thestealth131205/BMW-OBD2-Display/assets/multi_bg.jpg

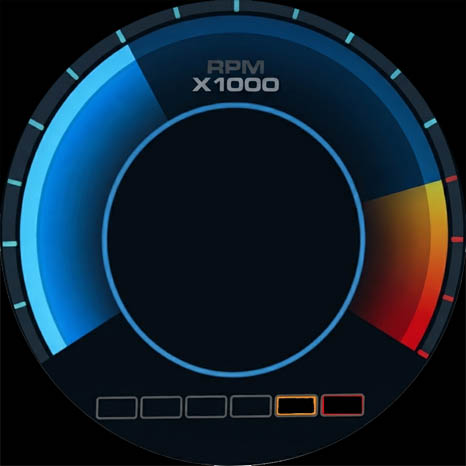
assets/multi_bg.jpg
