thestealth131205/BMW-OBD2-Display/2.1 LCD/demo projekt/esp-idf - ESP32-S3-Touch-LCD-2.1-Test/README.md

# BMW E90 OBD2 Display – ESP32-S3-Touch-LCD-2.1 (RGB, ESP-IDF)

Portierung der BMW-E90-Multi-Anzeige (siehe Haupt-`CLAUDE.md` im Repo-Root) auf
das Waveshare-Board **ESP32-S3-Touch-LCD-2.1** (480×480 ST7701S RGB-Display,
CST820-Touch). Framework: **ESP-IDF** (nicht Arduino/PlatformIO), LVGL v8.2
via ESP Component Manager. Basis ist das offizielle Waveshare-Demo-Projekt,
darauf aufgebaut liegt die BMW-UI in `main/BMW_UI/`.

Der eingebaute Waveshare-Demo-Screen bleibt erreichbar: **3 Sekunden Touch in
der Bildschirmmitte** zeigt ihn an, ein „Zurück“-Button führt zur BMW-Ansicht
zurück. **Doppeltipp** in der Mitte öffnet den Farb-Einstellungsbildschirm.

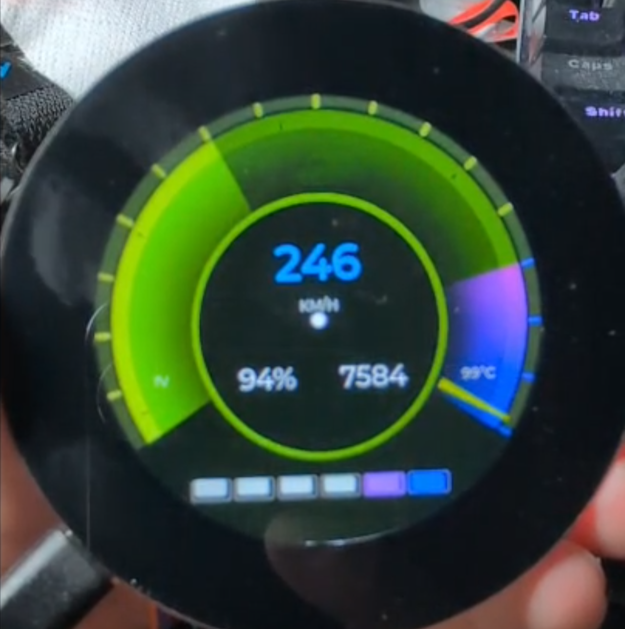
[picture p4: 2.1 LCD/demo projekt/esp-idf - ESP32-S3-Touch-LCD-2.1-Test/docs/multi_view_photo.png]
Multi-Ansicht auf dem Display


## Hardware

| Komponente | Modell |
|---|---|
| Mikrocontroller | ESP32-S3 (Waveshare ESP32-S3-Touch-LCD-2.1) |
| Display | ST7701S RGB-TFT, 480×480, über SPI-Init + paralleles RGB-Interface |
| Touch | CST820 (kapazitiv), I2C |
| IO-Expander | TCA9554 (Adresse 0x20) – steuert u. a. Touch-Reset/weitere Enable-Leitungen |
| CAN-Bus | externes **MCP2515-Modul** (SPI, TJA1050-Transceiver) oder alternativ **BLE-OBD-Adapter** (Veepeak OBDCheck BLE) |
| Batteriemessung | interner ADC (Spannungsteiler auf dem Board) |

Board-eigene Peripherie (RTC PCF85063, IMU QMI8658, microSD, WLAN) ist aus dem
Waveshare-Demo übernommen und unverändert nutzbar, wird von der BMW-UI aber
nicht benötigt.

## Verdrahtungsplan

### ST7701S-Display (fest verlötet, keine externe Verdrahtung nötig)

Das Display ist bereits fest mit dem ESP32-S3-Modul verlötet (Waveshare-
Compound-Board). Pin-Zuordnung nur zur Referenz (`main/LCD_Driver/ST7701S.h`):

| Signal | GPIO | Signal | GPIO |
|---|---|---|---|
| SPI SDA (Init) | 1 | SPI SCLK (Init) | 2 |
| HSYNC | 38 | VSYNC | 39 |
| DE | 40 | PCLK | 41 |
| Backlight (PWM) | 6 | | |
| B0–B4 (DATA0–4) | 5, 45, 48, 47, 21 | | |
| G0–G5 (DATA5–10) | 14, 13, 12, 11, 10, 9 | | |
| R0–R4 (DATA11–15) | 46, 3, 8, 18, 17 | | |

### I2C-Bus (Touch CST820 + IO-Expander TCA9554)

| Signal | GPIO |
|---|---|
| SCL | 7 |
| SDA | 15 |
| Touch-INT | 16 |
| Touch-RST | -1 (nicht verbunden, Reset über TCA9554) |

Ebenfalls fest verlötet, keine externe Verdrahtung nötig.

### MCP2515-CAN-Modul (extern anzuschließen – einzige Verdrahtung, die der
Nutzer selbst vornehmen muss)

**Wichtig:** Auf dem ESP32-S3-Touch-LCD-2.1 sind fast alle GPIOs durch das
RGB-Display und I2C belegt. Nur **GPIO 0, 19, 20, 43, 44** sind frei
herausgeführt. Verdrahtung des MCP2515-Moduls (blaue Platine mit TJA1050,
`main/CAN_Driver/mcp2515.h`):

| MCP2515-Modul | ESP32-S3 GPIO | Funktion |
|---|---|---|
| VCC | 3V3 | Versorgung |
| GND | GND | Masse |
| SCK | GPIO43 | SPI-Takt |
| SI (MOSI) | GPIO44 | SPI Data ESP→MCP2515 |
| SO (MISO) | GPIO19 | SPI Data MCP2515→ESP |
| CS | GPIO20 | SPI Chip-Select |
| INT | *nicht verbunden* | reiner Software-Poll über SPI (`mcp2515.c`), kein ISR-Pin nötig |

**GPIO0 bleibt dadurch dauerhaft frei** für den LED-Control-Screen (siehe
unten) – unabhängig davon, ob BLE-OBD oder MCP2515 als Datenquelle gewählt
ist.

Danach MCP2515 → CAN-Transceiver (TJA1050 ist meist schon auf dem Modul
integriert) → BMW E90 OBD2-Stecker:

| OBD2-Pin | Signal |
|---|---|
| Pin 6 | CANH |
| Pin 14 | CANL |

Baudrate: **500 kbit/s**. Quarz auf dem MCP2515-Modul muss zu
`MCP2515_XTAL_MHZ` in `mcp2515.h` passen (Standard: 8 MHz – am Modul
nachprüfen, sonst stimmt die Baudrate nicht).

**Achtung Pin-Konflikt:** GPIO43/44 sind gleichzeitig die UART-Konsole des
ESP32-S3. Mit dieser Pinbelegung ist die serielle Debug-Ausgabe (`idf.py
monitor`) zur Laufzeit nicht nutzbar (Flashen funktioniert weiterhin über den
USB-Download-Modus). GPIO19/20 sind außerdem die nativen-USB-Pins – auch diese
Funktion steht dadurch nicht mehr zur Verfügung.

## Software / Build

```bash
# Im Projektverzeichnis (ESP-IDF-Environment muss aktiviert sein, z. B. via
# `. $HOME/esp/esp-idf/export.sh`)
idf.py set-target esp32s3
idf.py build
idf.py -p PORT flash monitor
```

- **LVGL** wird per Component-Manager (`main/idf_component.yml`) geladen,
  Version 8.2. Der vendorte Ordner `components/lvgl__lvgl/` wird von CI/Build
  automatisch nachgezogen und ist per `.gitignore` vom Repo ausgeschlossen.
- **Flash-Layout**: 16 MB, Zwei-Slot-OTA-Partitionstabelle (`ota_0`/`ota_1` à
  3 MB + `otadata`, siehe `partitions.csv`) – ein WLAN-Update schreibt immer
  in den gerade nicht laufenden Slot, ein fehlgeschlagener Upload überschreibt
  also nie die aktuell laufende Firmware.
- **CI**: `.github/workflows/build-s3.yml` baut das Projekt per
  `espressif/esp-idf-ci-action` (ESP-IDF v5.3.1, Target `esp32s3`) und lädt
  bei Push auf `test_waveshare` drei Dateien in das GitHub-Release
  **`s3-latest`** sowie zusätzlich versioniert in **`v<Version>`**
  (Version aus `VERSION`):
  - **`firmware-s3-update.bin`** – reines App-Image, für das **WLAN-Update**
    (siehe unten). Name bewusst mit `_update`-Suffix, damit er sich nicht mit
    der `-merged.bin` verwechseln lässt.
  - **`firmware-s3.elf`** – fürs Debugging (Backtrace-Symbole).
  - **`firmware-s3-merged.bin`** – Bootloader + Partitionstabelle + App,
    gemerged an den Offsets `0x0`/`0x8000`/`0x20000`, nur fürs **initiale
    USB-Flashen** gedacht (`esptool write-flash 0x0 firmware-s3-merged.bin`).

## WLAN-Firmware-Update (OTA)

Im originalen Waveshare-Onboard-Panel (3 Sekunden Touch in der
Bildschirmmitte → dort wo auch Helligkeit/SD-Größe/RTC stehen) gibt es einen
Schalter **„WLAN-Update“**. Aktiviert er:

1. Das Display baut einen eigenen WLAN-Access-Point auf
   (SSID `BMW-E90-OTA`, Passwort `bmw320i2010`) und zeigt SSID/Passwort/IP
   sowie einen Fortschrittsbalken an.
2. Handy/PC verbindet sich mit diesem WLAN und ruft `http://192.168.4.1` im
   Browser auf.
3. Dort **nur die Datei `firmware-s3-update.bin`** auswählen und hochladen –
   **nicht** die `-merged.bin`, die ist ausschließlich fürs USB-Flashen.
4. Nach erfolgreichem Upload schreibt das Display `esp_ota_set_boot_partition`
   und startet automatisch in die neue Firmware neu.

**Schutz vor der falschen Datei:** `main/OTA_Web/ota_web.c` liest nach den
ersten paar hundert empfangenen Bytes den App-Beschreibungsblock
(`esp_app_desc_t`) aus der gerade beschriebenen Partition zurück
(`esp_ota_get_partition_description`). Fehlt dort das erwartete
`ESP_APP_DESC_MAGIC_WORD` – z. B. weil versehentlich die `-merged.bin`
hochgeladen wurde, bei der an dieser Stelle der Bootloader statt des
App-Headers steht – bricht der Upload sofort mit einer Fehlermeldung ab,
statt eine ungültige Firmware zu flashen.

**Wichtig:** Da `partitions.csv` ein Zwei-Slot-OTA-Layout ist, muss nach
einer Änderung der Partitionstabelle selbst einmal regulär per USB geflasht
werden – danach funktioniert das WLAN-Update für alle folgenden Versionen.

## RTC-Zeitabgleich per SNTP über Hotspot

Eigenes Modul `main/SNTP/sntp_sync.c`, unabhängig vom WLAN-Update-AP oben:
Hier verbindet sich das Display als **Client** mit einem WLAN, das
Internetzugang hat (Handy-Hotspot/Heim-WLAN), um die PCF85063-RTC einmalig
per SNTP (`pool.ntp.org`) zu stellen.

- Ausgelöst wird das **ausschließlich** über den Schalter **„Hotspot
  verbinden“** im Funktionen-Screen (Doppeltipp → Wisch rechts, siehe
  BMW-UI-Logik unten) – **kein** automatischer Versuch beim Boot, damit die
  BLE-OBD-Verbindung nicht unbeabsichtigt (z. B. während der Fahrt) gestört
  wird.
- Zugangsdaten stehen in `/sdcard/wifi-einstellungen.txt` auf der SD-Karte
  (bewusst nicht im Code, dieses Repo ist öffentlich). Fehlt die Datei noch,
  legt der erste Versuch automatisch eine Vorlage mit Beispiel an.
- Ablauf: BLE-OBD kurz pausieren (gleiche Antennen-Koexistenz wie beim
  WLAN-Update) → per STA verbinden → SNTP-Sync → Zeit lokal (inkl.
  Sommerzeit) in die RTC schreiben → BLE-OBD fortsetzen. Ein Statustext unter
  dem Schalter zeigt den Fortschritt, der Schalter fällt nach dem (einmaligen)
  Versuch automatisch wieder ab.
- Der Schalterzustand wird **nicht** in NVS gespeichert – nach jedem Neustart
  ist er wieder aus. Mit einer RTC-Pufferbatterie reicht ein einziger
  erfolgreicher Abgleich.

**SD-Karte formatieren** (`SD_MMC.c: SD_Format()`): Button direkt unter dem
Hotspot-Schalter im Funktionen-Screen, für unformatierte/beschädigte Karten
(z. B. „SD-Fehler!“ bei Datenlogging oder „Fehler: zu wenig Speicher“ beim
Hotspot-Task, weil `SD_EnsureMounted()` nie erfolgreich mountet). Ist die
Karte bereits gemountet, läuft `esp_vfs_fat_sdcard_format()` (hängt selbst
aus/ein); ist sie es nicht, erfolgt ein einmaliger erzwungener
Formatierungs-Mount (`format_if_mount_failed=true`). Aktives Datenlogging
wird vorher gestoppt, die eigentliche Formatierung läuft in einem eigenen
Task, damit die UI währenddessen nicht einfriert.

## OBD2 / CAN-Auswertung (MCP2515-Quelle)

Läuft über `main/CAN_Driver/` (eigener MCP2515-SPI-Treiber +
Decode-Task, kein ESP-IDF-`twai`). CAN-IDs identisch zum C6-Hauptprojekt –
**Platzhalter**, am Fahrzeug per CAN-Sniffer verifizieren:

| CAN-ID | Inhalt |
|---|---|
| `0x0AA` | Drehzahl (Byte 2–3 LE × 0,25 = U/min) |
| `0x0C4` | G-Kraft (Byte 0/1 int8 × 0,01 = g) + Geschwindigkeit (Byte 2–3 LE × 0,1 = km/h) |
| `0x1D0` | Kühlmitteltemperatur (Byte 0 − 40 = °C) |
| `0x1F0` | Gaspedalstellung (Byte 0 linear 0–255 → 0–100 %) |
| `0x7DF` | OBD2-Funktionsadresse (DTC lesen/löschen, Mode 03/04) |
| `0x611` | Kombiinstrument (CBS-Öl-Service-Reset, UDS Service `0x31`) |

Solange kein CAN-Signal anliegt (`CAN_OBD2_online()` == false), zeigt die UI
Platzhalterwerte/Testanimation an. Batteriespannung kommt weiterhin vom
internen ADC (`BAT_Driver`), nicht von CAN.

## Datenquelle: BLE-OBD oder MCP2515

Das Display kann seine Live-Daten aus zwei Quellen beziehen. Die Auswahl
erfolgt im Demo-Menü (**3 Sekunden Touch in der Bildschirmmitte**) über die
Buttons **„BLE OBD“** und **„MCP“** (aktive Quelle grün). **Standard ist
BLE OBD.** Die Wahl gilt für alle Live-Werte, DTC-Lesen/-Löschen,
Service-Reset und das CSV-Logging.

| Quelle | Hardware | Modul |
|---|---|---|
| **BLE OBD** (Standard) | ELM327-Adapter mit Bluetooth LE, z. B. **Veepeak OBDCheck BLE** | `main/BLE_OBD/` |
| **MCP** | MCP2515-Modul direkt am PT-CAN (siehe Verdrahtung oben) | `main/CAN_Driver/` |

### BLE-OBD-Adapter (Veepeak OBDCheck BLE)

- Der ESP32-S3 hat nur **Bluetooth 5 LE**, kein klassisches Bluetooth
  (BR/EDR/SPP). Adapter, die nur klassisches Bluetooth sprechen (z. B.
  Veepeak **VP11**), können deshalb **nicht** verbunden werden – es muss ein
  BLE-Adapter sein.
- Beim Start initialisiert das Display Bluetooth und scannt fortlaufend nach
  Geräten, deren Name `OBD`, `VEEPEAK`, `VLINK` oder `ELM327` enthält
  (Groß-/Kleinschreibung egal). Der Veepeak-Adapter meldet sich als
  **VEEPEAK**. Bei Fund wird automatisch verbunden.
- Die GATT-Charakteristiken (Notify = RX, Write = TX) werden generisch
  erkannt, da ELM327-Klone unterschiedliche UUIDs verwenden.
- **Kopplung:** Bei BLE ist normalerweise keine Kopplung nötig (Sicherheit:
  `ESP_LE_AUTH_NO_BOND`). Verlangt ein Adapter dennoch eine PIN, probiert das
  Display nacheinander **1234 → 5678 → 0000**.
- Nach dem Verbinden: `ATZ`, `ATE0`, `ATH0`, `ATSP6` (ISO 15765-4 CAN,
  500 kbit/s), danach zyklisches Polling per Standard-OBD2:
  Drehzahl, Geschwindigkeit, Kühlmitteltemperatur, Gaspedalstellung,
  Batteriespannung (`ATRV`) sowie DTC lesen/löschen (Mode 03/04) und
  Service-Reset.
- **Einschränkung:** G-Kraft ist über Standard-OBD2 nicht verfügbar und
  bleibt bei BLE-OBD auf 0,0 – dafür wird die MCP-Quelle benötigt.
- Der BLE-Scan startet erst ca. 7 s nach dem Boot, um den bestehenden Scan
  der Waveshare-Demo (`Wireless.c`) nicht zu stören.
- Ein BLE-Adapter benötigt **keine** Verdrahtung – GPIO19/20/43/44 bleiben bei
  reiner BLE-Nutzung frei (MCP2515 dann nicht anschließen).

## LED-Steuerung (WS2812B/SK6812)

Wisch nach oben auf der Multi-Ansicht öffnet den Screen „LED CONTROL“
(`main/LED_Control/led_ctrl.c`, RMT-Backend über die Komponente
`espressif/led_strip`), Wisch nach unten geht zurück. **Zwei unabhängig
steuerbare Streifen**, oben im Screen per Tab umschaltbar, beide laufen im
Hintergrund parallel weiter.

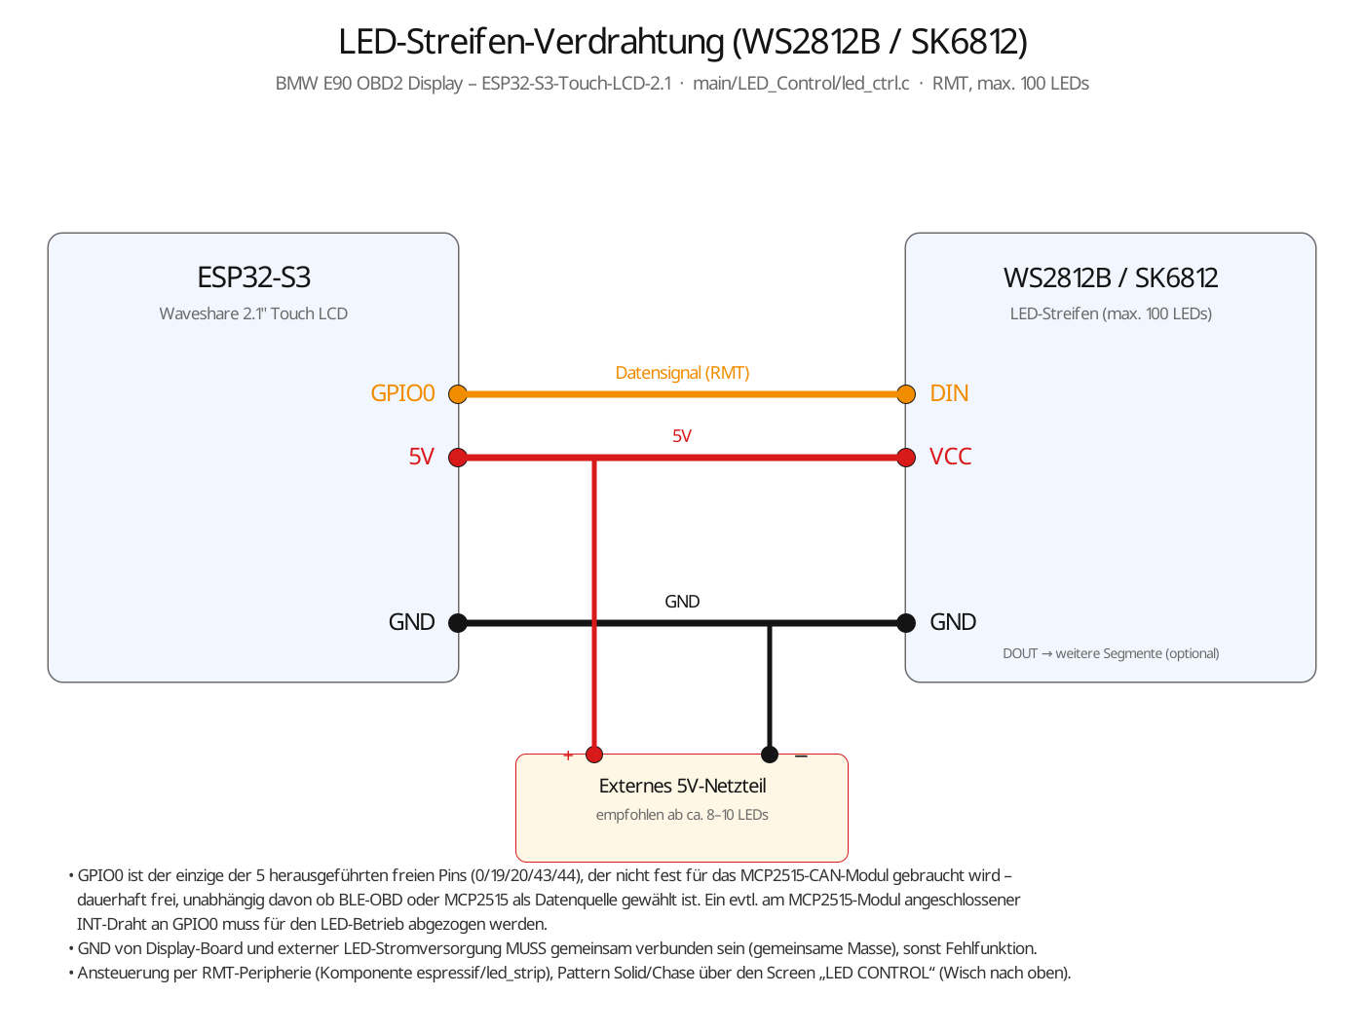
[picture p5: 2.1 LCD/demo projekt/esp-idf - ESP32-S3-Touch-LCD-2.1-Test/docs/led_wiring.png]
LED-Streifen-Verdrahtung


| Streifen | ESP32-S3 GPIO | Funktion |
|---|---|---|
| Streifen 1 – DIN | **GPIO0** | WS2812/SK6812-Protokoll (RMT), immer frei |
| Streifen 2 – DIN | **GPIO19** | WS2812/SK6812-Protokoll (RMT), **= MCP2515-MISO** |
| VCC (beide) | 5V (extern, je nach LED-Anzahl – ab ca. 8–10 LEDs direkt vom KFZ-Bordnetz per 12V→5V-Step-Down statt vom ESP32-Board) | Versorgung |
| GND (beide) | GND | Masse |

- GPIO0 (Streifen 1) ist dauerhaft frei, unabhängig von der BLE/MCP-
  Datenquellenwahl. Ein evtl. am MCP2515-Modul angeschlossener INT-Draht an
  GPIO0 muss für den Streifen-1-Betrieb abgezogen werden.
- GPIO19 (Streifen 2) ist identisch mit MCP2515-MISO – SPI braucht alle 4
  Leitungen, Streifen 2 und das (verkabelte) MCP2515-Modul schließen sich
  deshalb gegenseitig aus. Für Streifen 2 muss die Datenquelle auf BLE-OBD
  stehen; die UI zeigt auf dem Streifen-2-Tab einen Warnhinweis, solange die
  Datenquelle trotzdem auf MCP2515 steht.
- Je Streifen: max. 100 LEDs, Ein-/Ausschalter (RMT-Ausgang wird erst bei
  aktivem Schalter konfiguriert), zwei Muster: **Solid** (eine Farbe) und
  **Chase** (Hauptfarbe als Hintergrund, Zweitfarbe läuft mit kurzem Schweif
  im Loop, Geschwindigkeit per Regler).
- Anzahl und beide Farben (10er-Palette, volle 8-Bit-RGB-Werte statt der
  RGB565-Display-Darstellung) je Streifen separat per Regler/Farbauswahl
  einstellbar, alle Einstellungen beider Streifen in NVS gespeichert.

## UI-Logik (Kurzfassung)

- **Boot-Logo**: Direkt nach der LVGL-Initialisierung zeigt das Display
  1,8 Sekunden lang ein Vollbild-Logo auf schwarzem Grund
  (`main/BMW_UI/boot_logo_img.c/.h`, 480×480 RGB565), bevor die eigentliche
  UI (Demo-Screen + BMW-Multi-Ansicht) aufgebaut wird.

Details zur BMW-Multi-Ansicht (Anzeigen, Farbzonen, Schwellenwerte, Nadeln,
Einstellungs-Screen) siehe Haupt-`CLAUDE.md` im Repo-Root – die Logik ist
weitgehend 1:1 vom C6-Projekt übernommen (`main/BMW_UI/bmw_ui.c`). Abweichungen
zum C6-Projekt:

- Ringnadel der Multi-Kachel zeigt Kühlmitteltemperatur (Skala 40–119 °C,
  ab 95 °C Farbwechsel), Drehzahl bleibt zusätzlich digital sichtbar.
- Zusätzliche, immer aktive innere Leuchtskala (Vorbild: segmentierte
  Kühlmitteltemperatur-Anzeige im BMW-Kombiinstrument): zeigt unabhängig vom
  gewählten Anzeige-Modus des Haupt-Rings (Wasser/Drehzahl) stets die
  Kühlmitteltemperatur – Blau als Grundfarbe, ab 100 °C Orange, ab 115 °C Rot.
- Schaltpunkt-Kästchen (6 Stück) füllen sich einzeln je nach Drehzahl
  (aktuelle Schwellen: 1500/2500/3500/4500/5500/6500 U/min), ab 6800 U/min
  blinken alle gemeinsam.
- Farbverwaltung/Nadel-Auswahl per Einstellungs-Screen (Doppeltipp), analog
  zur Farbpalette im C6-Projekt.
- Funktionen-Screen (Wisch rechts ab Einstellungs-Screen) enthält zusätzlich
  den Schalter „Hotspot verbinden“ für den manuellen RTC-Zeitabgleich per
  SNTP (siehe eigener Abschnitt oben) – im C6-Projekt nicht vorhanden.
- Neuer Screen „SENSOREN“ (Wisch rechts ab dem Service-Screen, Wisch links
  zurück): reine Digitalwert-Anzeige, 4 Zeilen × 2 Spalten – Lambda Sensor
  1/2 oben, darunter deren Spannungswerte, darunter Ansaugkrümmerdruck (MAP)
  und Ladedruck, unten Nockenwellen-Position Einlass/Auslass. Lambda
  (`BLE_OBD_lambda1_ratio()`/`..._voltage()` bzw. `CAN_OBD2_...`, PID 0x24/
  0x25) und Ansaugdruck (PID 0x0B) kommen live von der eingestellten
  Datenquelle. Ladedruck und Nockenwellen-Position liefern immer -1.0
  (Anzeige „n/v“): Für Ladedruck gibt es keine standardisierte Mode-01-PID
  und der N43B20A hat laut Haupt-`CLAUDE.md` ohnehin keinen Turbo; für die
  VANOS-Nockenwellenposition existiert gar kein Standard-OBD2-PID, das wäre
  nur per BMW-spezifischem UDS-Identifier auslesbar und wurde bewusst nicht
  blind nachgebaut (ungeprüfte Diagnosebefehle an Steuergeräte sind riskant,
  vgl. die ebenfalls offenen Punkte NOx-Regeneration/Bremsenentlüften im
  Service-Screen). Die Zuordnung „Lambda 1/2“ zu „Bank 1/2“ ist eine Annahme
  – Standard-OBD2 nummeriert O2-Sensoren 1–8 durchlaufend, die Zuordnung zu
  Bank1/Bank2 ist fahrzeugabhängig; beim N43 als Reihenmotor mit nur einer
  Bank sind das vermutlich Sensor vor/nach Kat derselben Bank, nicht zwei
  getrennte Bänke – am Fahrzeug noch zu verifizieren.
- Neuer Screen „LED CONTROL“ (Wisch oben ab der Multi-Ansicht, Wisch unten
  zurück): Ansteuerung eines WS2812B/SK6812-Streifens an GPIO0 (siehe eigener
  Abschnitt oben) – im C6-Projekt nicht vorhanden.
