thestealth131205/BMW-OBD2-Display/2.1 LCD/demo projekt/esp-idf - ESP32-S3-Touch-LCD-2.1-Test/main/main.c

#include <stdio.h>
#include <inttypes.h>
#include "sdkconfig.h"
#include "freertos/FreeRTOS.h"
#include "freertos/task.h"
#include "freertos/semphr.h"
#include "TCA9554PWR.h"
#include "PCF85063.h"
#include "QMI8658.h"
#include "ST7701S.h"
#include "CST820.h"
#include "SD_MMC.h"
#include "sd_log.h"
#include "sd_update.h"
#include "LVGL_Driver.h"
#include "LVGL_Example.h"
#include "Wireless.h"
#include "bmw_ui.h"
#include "can_obd2.h"
#include "ble_obd.h"
#include "sntp_sync.h"
#include "led_ctrl.h"
#include "esp_core_dump.h"
#include "boot_logo_img.h"

// Boot-Start-Logo: kurz auf schwarzem Grund anzeigen, bevor die eigentliche
// UI (Demo-Screen + BMW-Multi-Ansicht) aufgebaut wird. LVGL braucht dafuer
// bereits einen laufenden Tick-Timer (siehe LVGL_Init()); der eigentliche
// Refresh passiert erst durch die manuellen lv_timer_handler()-Aufrufe in
// dieser Funktion, da die Haupt-while(1)-Schleife erst danach startet.
#define BOOT_LOGO_HOLD_MS 1800

static lv_obj_t *show_boot_logo(void)
{
    lv_obj_t *scr_boot = lv_obj_create(NULL);
    lv_obj_set_style_bg_color(scr_boot, lv_color_black(), 0);
    lv_obj_set_style_bg_opa(scr_boot, LV_OPA_COVER, 0);
    lv_obj_set_style_border_width(scr_boot, 0, 0);

    lv_obj_t *logo = lv_img_create(scr_boot);
    lv_img_set_src(logo, &boot_logo_img);
    lv_obj_center(logo);

    lv_scr_load(scr_boot);

    uint32_t waited = 0;
    while (waited < BOOT_LOGO_HOLD_MS) {
        lv_timer_handler();
        vTaskDelay(pdMS_TO_TICKS(10));
        waited += 10;
    }

    return scr_boot;
}

// Die Boot-Loops/Abstuerze waehrend der Fahrt liessen sich bisher nicht
// diagnostizieren, weil der echte Panic-Grund/Backtrace nur auf der seriellen
// USB-Konsole ausgegeben wird - im Auto ist kein Rechner angeschlossen. Mit
// CONFIG_ESP_COREDUMP_ENABLE_TO_FLASH landet ein Crash-Dump stattdessen auf
// der eigenen "coredump"-Partition (partitions.csv) und bleibt bis zum
// naechsten Boot erhalten. Hier wird er beim Start geprueft, die wichtigsten
// Angaben (Absturzursache, Programmzaehler, Backtrace-Adressen) gehen ins
// SD-Log, danach wird der Dump geloescht, damit er nicht erneut gemeldet wird.
static void log_and_clear_coredump(void)
{
    if (esp_core_dump_image_check() != ESP_OK) {
        return; // kein Dump vorhanden
    }

    // Erst loeschen, dann (bestenfalls) auswerten: Ein beschaedigter Dump
    // (z. B. durch einen Reset waehrend des Schreibens) kann das Parsen in
    // esp_core_dump_get_summary() selbst zum Absturz bringen - das wuerde
    // einen Boot-Loop erzeugen, der sich nie aufloest, weil der fehlerhafte
    // Dump sonst bis zum naechsten Boot liegen bleibt und wieder geparst
    // wird. Mit dem Loeschen zuerst ist der Loop spaetestens nach einem
    // einzigen Absturz durchbrochen, auch wenn die Diagnose-Zeile darunter
    // selbst nicht mehr zustande kommt.
    esp_core_dump_summary_t summary;
    esp_err_t summary_err = esp_core_dump_get_summary(&summary);

    esp_core_dump_image_erase();

    if (summary_err == ESP_OK) {
        SD_Log("=== COREDUMP gefunden: Task '%s', PC=0x%08" PRIx32 ", exc_cause=%" PRIu32 ", exc_vaddr=0x%08" PRIx32,
               summary.exc_task, summary.exc_pc, summary.ex_info.exc_cause, summary.ex_info.exc_vaddr);
        char bt[256];
        int p = 0;
        for (uint32_t i = 0; i < summary.exc_bt_info.depth && i < 16; i++) {
            p += snprintf(bt + p, sizeof(bt) - p, "0x%08" PRIx32 " ", summary.exc_bt_info.bt[i]);
            if (p >= (int)sizeof(bt) - 12) break;
        }
        SD_Log("COREDUMP Backtrace (corrupted=%d): %s", (int)summary.exc_bt_info.corrupted, bt);
    } else {
        SD_Log("=== COREDUMP vorhanden, aber Zusammenfassung konnte nicht gelesen werden ===");
    }
}

void Driver_Loop(void *parameter)
{
    while(1)
    {
        QMI8658_Loop();
        RTC_Loop();
        BAT_Get_Volts();
        vTaskDelay(pdMS_TO_TICKS(100));
    }
    vTaskDelete(NULL);
}
void Driver_Init(void)
{
    Flash_Searching();
    BAT_Init();
    I2C_Init();
    PCF85063_Init();
    QMI8658_Init();
    EXIO_Init();                    // Example Initialize EXIO
    xTaskCreatePinnedToCore(
        Driver_Loop, 
        "Other Driver task",
        4096, 
        NULL, 
        3, 
        NULL, 
        0);
}
void app_main(void)
{   
    Wireless_Init();
    Driver_Init();

    LCD_Init();
    Touch_Init();
    SD_Init();
    SD_Log_Init();
    log_and_clear_coredump();

    // LVGL/Boot-Logo bewusst VOR die beiden SD-Schritte unten vorgezogen (bis
    // v1.0.75 liefen sie erst danach, siehe LVGL_Init()/show_boot_logo() weiter
    // unten im Original): Seit v1.0.69-71 blieb der Bildschirm bei manchen
    // Boots komplett schwarz, ohne dass ein neuer Log-Eintrag dazukam - der
    // naechste SD-Zugriff (SNTP_Sync_EnsureConfigFile()/SD_Update_CheckAndApply())
    // ist der einzige main.c-Unterschied zur zuletzt sicher funktionierenden
    // v1.0.68. Mit dem Boot-Logo zuerst zeigt das Display jetzt IMMER
    // mindestens das Logo, selbst falls einer der beiden SD-Schritte danach
    // haengt - das grenzt beim naechsten Vorfall sofort ein (Logo sichtbar =
    // Haenger danach, schwarz = Haenger noch frueher) und verschlimmert das
    // eigentliche Problem nicht, da beide Funktionen ohnehin unabhaengig von
    // LVGL sind.
    LVGL_Init();
    lv_obj_t *scr_boot = show_boot_logo();

    // Legt /sdcard/wifi-einstellungen.txt (SSID/PASSWORT/LAYOUT/DATALOGGING)
    // an, falls sie auf dieser Karte noch fehlt - bisher entstand sie erst
    // beim ersten "Hotspot verbinden"-Versuch, wurde also auf einer nie dafuer
    // genutzten Karte nie angelegt. So frueh wie moeglich (direkt nach
    // SD_Log_Init()), damit Layout/Datenlogging von der allerersten Boot-
    // Sitzung an per SD-Karte vorkonfigurierbar sind.
    SNTP_Sync_EnsureConfigFile();

    // Liegt eine update.bin im Root der SD-Karte, wird sie hier als neue
    // Firmware eingespielt und danach in update.backup umbenannt - bei Erfolg
    // startet das Geraet selbst neu und kehrt aus app_main() nicht zurueck.
    // Deshalb so frueh wie moeglich (direkt nach SD-Mount/Log-Init), bevor
    // LVGL/CAN/BLE unnoetig initialisiert werden.
    SD_Update_CheckAndApply();

    // OS-Flag (Bit 7 Sekunden-Register) des PCF85063: wird vom Chip selbst
    // gesetzt, wenn die Pufferversorgung (RTC-Batterie) mal eingebrochen ist
    // und die Zeit dadurch ungueltig wurde (Pendant zu lostPower() bei
    // anderen RTC-Libs). Bleibt gesetzt, bis der naechste erfolgreiche
    // SNTP-Abgleich (write_time_to_rtc() in sntp_sync.c) die Zeit neu
    // schreibt - erst DANN ist eine Aussage ueber die Batterie moeglich.
    if (PCF85063_Lost_Power()) {
        SD_Log("RTC: Pufferversorgung ausgefallen (OS-Flag gesetzt) - Zeit nach Stromverlust ungueltig, Batterie pruefen!");
    } else {
        SD_Log("RTC: OS-Flag nicht gesetzt - Pufferversorgung hat seit letztem Zeitabgleich durchgehalten");
    }

    // Legt nur den SNTP-Hintergrund-Task an (blockiert sofort auf eine
    // Freigabe) - loest noch KEINEN Verbindungsversuch aus. Das passiert erst
    // gezielt per "Hotspot verbinden"-Schalter im Funktionen-Screen
    // (bmw_ui.c -> SNTP_Sync_Start()). Die Anlage muss aber so frueh wie
    // moeglich passieren, solange das interne DRAM noch nicht durch
    // LVGL/CAN/Bluedroid fragmentiert ist (siehe sntp_sync.c) - deshalb hier,
    // noch vor LVGL_Init()/CAN_OBD2_Init()/BLE_OBD_Init(), aber nach
    // SD_Log_Init(), damit die Init-Log-Zeile tatsaechlich auf der Karte
    // landet statt vor dessen Start zu verfallen.
    SNTP_Sync_Init();

    // OBD2 per MCP2515 (SPI) starten - liest PT-CAN-Broadcasts im Hintergrund
    CAN_OBD2_Init();

    // OBD2 per Bluetooth-LE-ELM327-Adapter (z.B. Veepeak OBDCheck BLE) -
    // scannt/verbindet im Hintergrund, Standard-Datenquelle in bmw_ui.c
    BLE_OBD_Init();

    // LED-Control-Screen (WS2812B/SK6812 an GPIO0): legt nur den
    // Hintergrund-Task an, der RMT-Ausgang wird erst bei aktivem Schalter
    // konfiguriert (siehe led_ctrl.c).
    LED_Ctrl_Init();
/********************* BMW Multi-Ansicht (Standard) + Waveshare-Demo *********************/
    // Demo-Seite des Waveshare-Projekts auf einem eigenen Screen aufbauen
    // (erscheint beim 3-Sekunden-Halten in der Bildschirmmitte).
    lv_obj_t *scr_demo = lv_obj_create(NULL);
    lv_scr_load(scr_demo);
    lv_obj_del(scr_boot);       // Boot-Logo-Screen wird nicht mehr gebraucht
    Lvgl_Example1();            // baut auf dem aktiven Screen = scr_demo auf

    // BMW-Multi-Ansicht als Standard-Screen laden.
    BMW_UI_Init(scr_demo);

    while (1) {
        // raise the task priority of LVGL and/or reduce the handler period can improve the performance
        vTaskDelay(pdMS_TO_TICKS(10));
        // The task running lv_timer_handler should have lower priority than that running `lv_tick_inc`
        lv_timer_handler();
    }
}
