thestealth131205/BMW-OBD2-Display/2.1 LCD/demo projekt/esp-idf - ESP32-S3-Touch-LCD-2.1-Test/main/BMW_UI/field_icons.c

// Automatisch generierte Symbol-Icons fuer die 4 Zusatzfelder der Multi-Kachel
// (Batterie/Gaspedal/Drehzahl/Wasser), RGB565+Alpha, LV_IMG_CF_TRUE_COLOR_ALPHA,
// LV_COLOR_16_SWAP=0, 3 Byte/Pixel (wie needle_imgs.c). Reine weisse Symbole mit
// Alpha-Kante aus Supersampling, 22x22 Pixel.
#include "field_icons.h"

const uint8_t icon_battery_map[1452] = {
255,255,0,255,255,0,255,255,0,255,255,0,255,255,0,255,255,0,255,255,0,255,255,0,255,255,0,255,255,0,
255,255,0,255,255,0,255,255,0,255,255,0,255,255,0,255,255,0,255,255,0,255,255,0,255,255,0,255,255,0,
255,255,0,255,255,0,255,255,0,255,255,0,255,255,0,255,255,0,255,255,0,255,255,0,255,255,0,255,255,0,
255,255,0,255,255,0,255,255,0,255,255,0,255,255,0,255,255,0,255,255,0,255,255,0,255,255,0,255,255,0,
255,255,0,255,255,0,255,255,0,255,255,0,255,255,0,255,255,0,255,255,0,255,255,0,255,255,0,255,255,0,
255,255,0,255,255,0,255,255,0,255,255,0,255,255,0,255,255,0,255,255,0,255,255,0,255,255,0,255,255,0,
255,255,0,255,255,0,255,255,0,255,255,0,255,255,0,255,255,0,255,255,0,255,255,0,255,255,0,255,255,1,
255,255,0,255,255,1,255,255,1,255,255,1,255,255,1,255,255,1,255,255,1,255,255,1,255,255,1,255,255,1,
255,255,1,255,255,1,255,255,1,255,255,0,255,255,0,255,255,0,255,255,0,255,255,0,255,255,0,255,255,1,
255,255,2,255,255,0,255,255,0,255,255,0,255,255,0,255,255,0,255,255,0,255,255,0,255,255,0,255,255,0,
255,255,0,255,255,0,255,255,0,255,255,0,255,255,0,255,255,1,255,255,2,255,255,0,255,255,0,255,255,0,
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
};

const lv_img_dsc_t icon_water_img = {
    .header = {
        .cf = LV_IMG_CF_TRUE_COLOR_ALPHA,
        .always_zero = 0,
        .reserved = 0,
        .w = 22,
        .h = 22,
    },
    .data_size = 22 * 22 * 3,
    .data = icon_water_map,
};
