thestealth131205/BMW-OBD2-Display/2.1 LCD/demo projekt/esp-idf - ESP32-S3-Touch-LCD-2.1-Test/main/SD_Card/sd_log.c

#include "sd_log.h"

#include <stdio.h>
#include <stdarg.h>
#include <string.h>
#include <unistd.h>

#include "freertos/FreeRTOS.h"
#include "freertos/task.h"
#include "freertos/semphr.h"
#include "esp_timer.h"
#include "esp_system.h"

#include "SD_MMC.h"
#include "PCF85063/PCF85063.h"

#define SD_LOG_PATH   "/sdcard/obd_log.txt"
#define SD_LOG_BUF    16384   // RAM-Puffer, wird vom Schreib-Task geleert
#define SD_LOG_LINE   320     // max. Laenge einer Zeile inkl. Zeitstempel/CRLF -
                               // muss die laengste COREDUMP-Backtrace-Zeile aus
                               // main.c (bis zu 16 Adressen) vollstaendig fassen,
                               // sonst wird der fuer die Fehlersuche wichtigste
                               // Teil (das Ende der Adressliste) abgeschnitten
#define SD_LOG_FLUSH_MS 300

static FILE *s_file = NULL;
static SemaphoreHandle_t s_mutex = NULL;
static char s_buf[SD_LOG_BUF];
static size_t s_len = 0;
static uint32_t s_dropped = 0;
// true, solange sd_log_task() gerade AUSSERHALB des Mutex auf s_file
// schreibt (fwrite/fflush/fsync) - wird selbst nur unter Mutex-Schutz
// gesetzt/geprueft. Ohne das konnte SD_Log_Deinit() (z.B. von
// sd_format_task() vor einer SD-Formatierung) den Datei-Handle exakt in
// diesem Fenster fclose()n, waehrend der Schreib-Task noch mitten im
// fwrite()/fsync() darauf war - ein use-after-close. Trat nicht bei jedem
// Format-Versuch auf (nur wenn der 300ms-Flush-Zyklus zufaellig genau
// dann lief), passt aber zum Muster der sporadischen Abstuerze.
static volatile bool s_write_in_progress = false;
static bool s_init_done = false;

// Schreibt den RAM-Puffer auf die Karte. SD-Zugriffe (fsync) dauern teils
// 10-100 ms und duerfen den Bluetooth-Stack nicht blockieren - deshalb
// laufen sie hier im eigenen Task und nicht im Aufrufer von SD_Log().
static void sd_log_task(void *arg)
{
    (void)arg;
    static char local[SD_LOG_BUF];
    while (1) {
        vTaskDelay(pdMS_TO_TICKS(SD_LOG_FLUSH_MS));

        xSemaphoreTake(s_mutex, portMAX_DELAY);
        size_t n = s_len;
        uint32_t dropped = s_dropped;
        if (n) memcpy(local, s_buf, n);
        s_len = 0;
        s_dropped = 0;
        if (n) s_write_in_progress = true; // noch unter Mutex gesetzt, siehe SD_Log_Deinit()
        xSemaphoreGive(s_mutex);

        if (n && s_file) {
            fwrite(local, 1, n, s_file);
            if (dropped) fprintf(s_file, "[log] %lu Zeilen verworfen (Puffer voll)\r\n", (unsigned long)dropped);
            fflush(s_file);
            // Karte kann waehrend der Fahrt physisch verschwinden (Wackelkontakt,
            // herausgerutscht) oder einen echten Schreibfehler melden - fsync()
            // liefert dann != 0. Ohne diese Pruefung wuerde hier alle 300ms
            // weiter blind auf einen toten Handle geschrieben, und eine danach
            // neu eingesteckte Karte wuerde nie erkannt (SDCard_Size bliebe > 0).
            if (fsync(fileno(s_file)) != 0) {
                fclose(s_file);
                s_file = NULL;
                s_init_done = false;
                SD_HandleIoError();
            }
        }
        s_write_in_progress = false;
    }
}

void SD_Log_Init(void)
{
    if (s_init_done) return;        // bereits initialisiert (z.B. verzoegertes
                                     // Remounten ueber SD_EnsureMounted())
    if (SDCard_Size == 0) return;   // keine Karte gemountet
    s_init_done = true;

    s_mutex = xSemaphoreCreateMutex();
    s_file = fopen(SD_LOG_PATH, "a");
    if (!s_file) return;

    datetime_t now;
    PCF85063_Read_Time(&now);
    // Reset-Grund (1=Power-on 3=SW 4=Panic 5=IntWDT 6=TaskWDT 7=WDT 9=Brownout) zur Analyse von Neustarts
    fprintf(s_file, "\r\n=== Start %04d-%02d-%02d %02d:%02d:%02d reset_reason=%d ===\r\n",
            now.year, now.month, now.day, now.hour, now.minute, now.second, (int)esp_reset_reason());
    fflush(s_file);
    fsync(fileno(s_file));

    xTaskCreatePinnedToCore(sd_log_task, "sd_log", 8192, NULL, 2, NULL, 1);
}

void SD_Log(const char *fmt, ...)
{
    if (!s_file || !s_mutex) return;

    char line[SD_LOG_LINE];
    int n = snprintf(line, sizeof(line), "[%lu] ", (unsigned long)(esp_timer_get_time() / 1000));
    va_list ap;
    va_start(ap, fmt);
    int m = vsnprintf(line + n, sizeof(line) - n - 2, fmt, ap);
    va_end(ap);
    if (m < 0) return;
    n += m;
    if (n > (int)sizeof(line) - 3) n = sizeof(line) - 3;
    line[n++] = '\r';
    line[n++] = '\n';

    xSemaphoreTake(s_mutex, portMAX_DELAY);
    if (s_len + n <= SD_LOG_BUF) {
        memcpy(s_buf + s_len, line, n);
        s_len += n;
    } else {
        s_dropped++;
    }
    xSemaphoreGive(s_mutex);
}

void SD_Log_Deinit(void)
{
    if (!s_mutex) return;

    xSemaphoreTake(s_mutex, portMAX_DELAY);
    // Solange der Schreib-Task gerade (ausserhalb des Mutex) auf s_file
    // schreibt, warten statt den Handle unter ihm wegzuziehen - siehe
    // Kommentar bei s_write_in_progress oben.
    while (s_write_in_progress) {
        xSemaphoreGive(s_mutex);
        vTaskDelay(pdMS_TO_TICKS(5));
        xSemaphoreTake(s_mutex, portMAX_DELAY);
    }
    if (s_file) {
        fclose(s_file);
        s_file = NULL;
    }
    s_len = 0;
    s_dropped = 0;
    s_init_done = false;
    xSemaphoreGive(s_mutex);
}
