thestealth131205/BMW-OBD2-Display/2.1 LCD/demo projekt/esp-idf - ESP32-S3-Touch-LCD-2.1-Test/main/BMW_UI/multi_bg_bmw_img.h

// BMW-Style-Hintergrundbild fuer die Multi-Daten-Kachel (466x466, RGB565).
// Rohdaten in multi_bg_bmw_img.c, aus vom Nutzer bereitgestelltem Foto generiert.
#pragma once

#include <lvgl.h>

extern const uint16_t multi_bg_bmw_map[466 * 466];
extern const lv_img_dsc_t multi_bg_bmw_img;
