thestealth131205/BMW-OBD2-Display/2.1 LCD/demo projekt/esp-idf - ESP32-S3-Touch-LCD-2.1-Test/main/SD_Card/SD_MMC.h

#pragma once

#include <stdbool.h>
#include <string.h>
#include <sys/unistd.h>
#include <sys/stat.h>
#include "esp_vfs_fat.h"
#include "sdmmc_cmd.h"
#include "driver/sdmmc_host.h"

#include "esp_flash.h"

#include "EXIO/TCA9554PWR.h"        

#define CONFIG_EXAMPLE_PIN_CLK  2
#define CONFIG_EXAMPLE_PIN_CMD  1
#define CONFIG_EXAMPLE_PIN_D0   42
#define CONFIG_EXAMPLE_PIN_D1   -1
#define CONFIG_EXAMPLE_PIN_D2   -1
#define CONFIG_EXAMPLE_PIN_D3   -1  // Using EXIO


esp_err_t SD_Card_CS_EN(void);
esp_err_t SD_Card_CS_Dis(void);

esp_err_t s_example_write_file(const char *path, char *data);
esp_err_t s_example_read_file(const char *path);

extern uint32_t SDCard_Size;
extern uint32_t Flash_Size;
extern volatile bool SD_Init_Done;
void SD_Init(void);
void Flash_Searching(void);

// Versucht erneut zu mounten, falls SDCard_Size noch 0 ist (Karte war beim
// Boot nicht eingelegt oder der Mount ist fehlgeschlagen, dann aber doch
// nachtraeglich eingelegt worden). War bereits erfolgreich gemountet, tut
// diese Funktion nichts. Gibt true zurueck, wenn die Karte danach gemountet
// ist.
bool SD_EnsureMounted(void);

// Sauberes Unmounten nach einem erkannten Schreib-/Sync-Fehler (fsync() liefert
// != 0, z.B. Karte waehrend des Betriebs gezogen oder physischer Defekt) -
// setzt SDCard_Size auf 0 zurueck, damit SD_EnsureMounted() beim naechsten
// Zugriff einen sauberen Neu-Mount versucht, statt mit einem toten
// Datei-Handle auf einen moeglicherweise gar nicht mehr vorhandenen/
// ausgetauschten Datentraeger weiterzuschreiben. Ohne dieses Zuruecksetzen
// wuerde z.B. eine danach frisch eingesteckte (andere) Karte nie erkannt,
// weil SD_EnsureMounted() wegen SDCard_Size>0 annimmt, es sei weiterhin
// dieselbe, bereits gemountete Karte vorhanden.
void SD_HandleIoError(void);

// Formatiert die SD-Karte (FAT). Ist die Karte bereits gemountet, wird sie
// ueber esp_vfs_fat_sdcard_format() neu formatiert (haengt intern selbst
// aus/ein). War sie dagegen nicht mountbar (z.B. unformatiert/beschaedigt),
// erfolgt ein einmaliger erzwungener Formatierungs-Mount-Versuch
// (format_if_mount_failed=true). Blockiert den Aufrufer - sollte nur aus
// einem eigenen Task, nicht aus dem LVGL-Haupttask, aufgerufen werden.
esp_err_t SD_Format(void);
