thestealth131205/BMW-OBD2-Display/2.1 LCD/demo projekt/esp-idf - ESP32-S3-Touch-LCD-2.1-Test/main/BMW_UI/boot_logo_img.h

// Boot-Start-Logo (thestealth), 480x480 RGB565, passend zum vollen Panel.
// Rohdaten in boot_logo_img.c, aus vom Nutzer bereitgestelltem Bild generiert.
#pragma once

#include <lvgl.h>

extern const uint16_t boot_logo_map[480 * 480];
extern const lv_img_dsc_t boot_logo_img;
