thestealth131205/BMW-OBD2-Display/(commit log)

2026-08-28 Initial commit: BMW E90 OBD2 Display Projekt
    ESP32-C6 CAN-Bus-Gauge-Display für BMW E90 320i mit LVGL-UI auf
    AMOLED-Rundcdisplay (Wasser-/Batterie-Rundinstrumente, Boot-Animation,
    DTC-Diagnose, CBS-Service-Reset).
    [bmw_e90_display.ino, main.cpp]
2026-08-28 Add GitHub Actions Workflow für PlatformIO-Build
    Kompiliert das ESP32-C6-Firmware-Image bei jedem Push/PR und lädt
    firmware.bin/.elf als Build-Artefakt hoch.
2026-08-28 Fix ESP32-C6 Arduino-Build via pioarduino-Fork; DTC-Screen als eigener Screen
    Der GitHub-Actions-Build schlug fehl, da die offizielle espressif32-Plattform
    das esp32-c6-devkitc-1-Board nicht mit dem Arduino-Framework unterstuetzt.
    platform in platformio.ini auf den pioarduino-Community-Fork umgestellt.
    Ausserdem: Fehlercode-Uebersicht als eigener Screen (Doppeltipp zum Oeffnen,
    mit Loeschen- und Zurueck-Button) statt dritter Tileview-Kachel.
    [main.cpp]
2026-08-28 Fix TJpg_Decoder-Include (falscher Header-Name TJpgDec.h)
    Build-Fehler: TJpgDec.h: No such file or directory. Der korrekte
    Header der bodmer/TJpg_Decoder-Library heisst TJpg_Decoder.h.
    [main.cpp]
2026-08-28 Fix undefined BLACK-Konstante in fillScreen()
    Build-Fehler: 'BLACK' was not declared in this scope. Die
    Arduino_GFX_Library definiert RGB565_BLACK statt BLACK.
    [main.cpp]
2026-08-28 README mit Pinbelegung und Anschlussplan hinzufügen
2026-08-28 Schwellenwert-Einstellungen für alle 3 Werte und Sekundäranzeigen ergänzen
    Neuer Einstellungs-Tileview mit je einer Kachel für Wasser/Batterie/Gaspedal,
    Warnschwelle und Limit/Alarmschwelle per +/- Buttons verstellbar. Batterie-
    und Gaspedal-Gauge zeigen jetzt die Kühlmitteltemperatur als Sekundärwert,
    die Wasser-Gauge zeigt die Batteriespannung.
2026-08-28 Drehzahl-Gauge mit 6-LED-Schaltpunktanzeige hinzufügen
2026-08-28 Farbverlauf aller 4 Anzeigen an Primärfarbe koppeln
    Skalenstriche, Beschriftung und Zonen-Bogen nutzen jetzt einheitlich die
    Primärfarbe und mischen erst ab ~10% vor der Warnschwelle zu Gelb/Orange
    und ab der Limit-/Alarmschwelle zu Rot, statt fixer Farbblöcke.
    [main.cpp]
2026-08-28 Startwerte 105°C/12,6V für Wasser-Screen ohne CAN-Verbindung setzen
2026-08-28 SD-Karten-Prüfung vor Boot-Animation ergänzen
    Ohne SD-Karte oder ohne vorhandenen Animationsordner wird die
    Boot-Animation übersprungen, statt im SPI-Timeout zu hängen.
2026-08-28 SH8601-Treiber, Touch-Support und G-Force-Anzeige hinzufügen
    - Eigener SH8601-Displaytreiber (Arduino_SH8601.h) ersetzt fehlerhaften
    CO5300-Konstruktoraufruf; QSPI-/RST-Pins gemäß offiziellem Waveshare-SDK
    korrigiert (Hauptursache für nicht funktionierendes Display)
    - I2C-Touch-Treiber (SCL=8/SDA=18, Adresse 0x38) als LVGL-Input-Device
    registriert, damit 3-Sekunden-Center-Touch und Doppeltipp funktionieren
    - Neue G-Force-Kachel (Polar-Raster, Primär-/Sekundärfarbe) ergänzt
    - Farbauswahl-Einstellungskachel mit vertikal scrollbaren Primär-/
    Sekundärfarb-Spalten inkl. Neongelb ergänzt
    [main.cpp]
2026-08-28 Build-Fehler beheben: nativen SH8601-Treiber der GFX-Bibliothek nutzen
    Lokaler include/Arduino_SH8601.h kollidierte mit der gleichnamigen Klasse,
    die die Bibliothek moononournation/GFX Library for Arduino (>=1.5.0) via
    platformio.ini (^1.4.7) bereits nativ mitbringt. Konstruktor-Signatur ist
    identisch, daher lokale Datei entfernt statt umzubenennen.
2026-08-28 Display-Helligkeit nach Init explizit setzen
    SH8601-Treiber initialisiert die Helligkeit in begin() nicht
    automatisch, daher blieb das AMOLED-Panel schwarz obwohl LVGL
    korrekt gerendert hat.
2026-08-28 Build-Fehler beheben: gfx-Typ auf Arduino_SH8601 fuer setBrightness()
    Arduino_GFX-Basisklasse kennt setBrightness() nicht - Zeigertyp
    korrigiert, damit der Helligkeits-Fix kompiliert.
    [main.cpp]
2026-08-28 Bootloop beheben: TCA9554-IO-Expander Power-Hold (IO6/IO7) im Boot setzen
    Ursache des Bootloops (rhythmisch flackernde grüne LED, PSU-unabhängig):
    Die Waveshare-1.43"-Platine haelt sich nur unter Strom, solange der
    TCA9554-IO-Expander (I2C 0x20) IO6 (Power-Hold-Latch) und IO7 HIGH haelt.
    Ohne diese Init schaltet sich das Board nach dem Einschalt-Impuls selbst
    wieder aus. initIoExpander() setzt beide vor der Display-Init. Zusaetzlich
    SD-CS auf GPIO15 korrigiert (teilt QSPI-Bus mit Display), gegen das
    offizielle Waveshare-Factory-SDK verifiziert.
    [main.cpp]
2026-08-28 CI: Merged-Flash-Image erzeugen, Boot-Debug-Logging ergaenzen
    - GitHub Action erstellt zusaetzlich firmware-merged.bin (Bootloader +
    Partitionstabelle + App per esptool merge_bin), die sich wie die
    Factory-Bin direkt an Flash-Offset 0x0 schreiben laesst, ohne Offset-
    Fehlerquelle
    - setup() gibt jetzt Serial-Statusmeldungen nach jedem Boot-Schritt aus
    (Wire, IO-Expander, Display-Init, SD, LVGL, UI, CAN) zur Diagnose des
    Bootloops
    - USB-CDC-Boot-Flags (ARDUINO_USB_CDC_ON_BOOT/ARDUINO_USB_MODE) gesetzt,
    damit Serial-Ausgaben ueber den nativen USB-Port sichtbar sind
2026-08-29 Multi-Kachel: eigenes Hintergrundbild statt generierter RPM-Ring-Grafik
    Verwendet das bereitgestellte Bild als statisches RGB565-Hintergrundbild
    fuer die Multi-Daten-Kachel (eingebettet ueber include/multi_bg_img.h).
2026-08-31 Gruenstich beheben: COLMOD 0x3A=0x55 statt 0x05, Tachonadel-Geometrie fixen
    [main.cpp]
2026-08-31 tftInit-Reihenfolge an Werks-BSP angleichen: MADCTL/COLMOD vor SLPOUT senden
    Restlicher Gruenstich bei Schwarz kam von falscher Kommando-Reihenfolge,
    nicht vom COLMOD-Wert allein. Werks-Treiber (esp_lcd_sh8601.c) sendet
    MADCTL(0x36)+COLMOD(0x3A) direkt nach Reset, VOR SLPOUT, und wiederholt
    nach DISPON nochmal WDBRIGHTNESSVALNOR=0xFF als letzten Init-Schritt.
    tftInit() bildet das jetzt 1:1 nach, NORON/INVOFF entfernt.
    [main.cpp]
2026-08-31 SH8601 GRAM-Offset korrigieren: col_offset1=6 wie im Waveshare-LVGL-Beispiel
    [main.cpp]
2026-08-31 Reset-Puls an Werks-BSP angleichen: 10ms LOW/150ms HIGH ohne Vorab-Puls
    [main.cpp]
2026-09-01 IO-Expander: fehlendes LCD_EN (EXIO2) ergaenzen
    Laut offizieller Waveshare-Pin-Tabelle ist EXIO2 des TCA9554 das
    Display-Enable-Signal (LCD_EN), nicht nur EXIO6/EXIO7. Ohne dieses
    Signal laeuft das Panel in einem undefinierten Power-Zustand -
    moeglicher weiterer Baustein fuer den hartnaeckigen Gruenstich bei
    Schwarz.
2026-09-02 Bild-Nadeln statt gezeichneter Linien, Flash-Groesse-Fix, linker Taster wechselt Kachel
    Ersetzt die per LVGL-Linien gezeichnete Tachonadel durch 3 Bild-Assets
    (Tuerkis/Gelb/Rot) je Anzeige, ausgewaehlt nach Sekundaerfarbe; die
    Multi-Kachel nutzt ein eigenes, kleineres Bild-Set. board_upload.flash_size/
    board_build.partitions in platformio.ini korrigieren die vom Waveshare-Modul
    abweichende Standard-8MB/Dual-OTA-Annahme des Board-Files. Linker Taster
    (GPIO9) springt einmal getippt zur naechsten Hauptkachel, synchron zum
    manuellen Wischen.
    [main.cpp, needle_imgs.h]
2026-09-02 LVGL rounder_cb ergaenzen: Flush-Rechtecke auf gerade Pixelgrenzen runden
    Wie im offiziellen Waveshare-Beispiel (lvgl_port.c) fehlte ein rounder_cb,
    der jedes Flush-Fenster auf gerade x1/y1- und ungerade x2/y2-Grenzen
    ausrichtet. Ohne das landen kleine Antialiasing-Flush-Bereiche mit
    ungeraden CASET-Grenzen im GRAM - moeglicher weiterer Baustein fuer den
    anhaltenden Gruenstich bei Schwarz.
2026-09-02 Migration auf nativen esp_lcd_sh8601-Treiber (ESP-IDF) statt Arduino_GFX
    Display-Init/Flush laufen jetzt über den von Waveshare vendorten
    esp_lcd_sh8601-Treiber (esp_lcd_panel_draw_bitmap, asynchroner
    Completion-Callback fuer lv_disp_flush_ready), analog zum offiziellen
    09_LVGL_V8_Test-Beispiel. Dabei zwei Bootstopper behoben: setup()
    referenzierte noch das entfernte gfx-Objekt, und eine doppelte
    disp_drv-Deklaration ueberdeckte die dateiweite Instanz, die dem
    QSPI-Callback uebergeben wird. Ungenutzte GFX-Library-Abhaengigkeit
    aus platformio.ini entfernt.
    [main.cpp]
2026-09-02 initDisplay(): Fehlerpruefung + Serial-Logging je esp_lcd-Schritt ergaenzen
    Diagnose fuer Reboot-Loop nach Migration auf esp_lcd_sh8601: bisher wurden
    alle esp_lcd/spi_bus-Rueckgabewerte ignoriert, wodurch ein frueher Hang
    (vor der ersten Serial-Ausgabe) unsichtbar blieb.
    [main.cpp]
2026-09-02 Fix: draw_buf vor initDisplay() initialisieren (Bootloop-Ursache)
    Der QSPI-Completion-Callback (notify_lvgl_flush_ready) wird bereits
    durch initDisplay()/clearDisplayBlack() asynchron ausgeloest und
    dereferenziert disp_drv.draw_buf. War das noch NULL, fuehrte das zu
    einem Store-Access-Fault-Bootloop direkt nach initDisplay.
    [main.cpp]
2026-09-02 I2C-Bus-Scan + Fehlerpruefung fuer IO-Expander-Writes ergaenzen
    Diagnose fuer schwarzes Display: prueft ob TCA9554 (0x20) und Touch
    (0x38) am I2C-Bus antworten, loggt Erfolg/Fehler der beiden
    initIoExpander()-Schreibvorgaenge.
2026-09-07 S3-Demo-Projekt (ESP-IDF/ST7701S) + BMW-Multi-Ansicht + CI-Workflow
    Waveshare ESP32-S3-Touch-LCD-2.1-Demo als Basis uebernommen, darauf die
    BMW-Multi-Ansicht (BMW_UI) aus dem C6-Projekt aufgebaut (Center-Hold zeigt
    die Original-Demo-Seite). GitHub-Action build-s3.yml baut das ESP-IDF-Projekt
    (esp32s3, IDF v5.3.1), erzeugt firmware-s3(-merged).bin und laedt sie als
    Release s3-latest. Vendored LVGL wird per idf_component.yml gefetcht statt
    committet.
    [partitions.csv]
2026-09-07 Fix S3-Build: img_lvgl_logo als eigenes Asset mitliefern
    Das Registry-LVGL-Paket kompiliert src/demos/ nicht (nur src/extra/), daher
    blieb img_lvgl_logo trotz LV_USE_DEMO_WIDGETS ungelinkt. Das Asset wird jetzt
    als BMW_UI/img_lvgl_logo.c mitgeliefert (Guard entfernt, Include auf lvgl.h
    angepasst) und die nun ueberfluessige Demo-Config zurueckgenommen.
    [img_lvgl_logo.c]
2026-09-08 S3: Settings-Menue (Doppeltipp), Nadel-Farbwechsel bei 95/106C, neuer Hintergrund, Zurueck-Button, Testanimation, MCP2515-CAN
2026-09-08 S3: Nadel-Assets getauscht, Gaspedal/Drehzahl-Font vergroessert, Schaltanzeige-LEDs mit Fuellung/Blinken
2026-09-08 Root-README auf S3/MCP2515-Hardware umgeschrieben, Foto in S3-README
    Die Root-README beschrieb noch das alte C6-Projekt (kein MCP2515,
    1.43" AMOLED); auf test_waveshare ist das aktuelle Projekt aber der
    ESP32-S3 mit 2.1" LCD und externem MCP2515-CAN-Modul.
2026-09-09 S3: Default-Helligkeit auf 95%, Zurueck-Button im Demo-Screen sichtbar gemacht
2026-09-21 S3: BLE-OBD2-Support (Veepeak OBDCheck BLE) + Datenquellen-Auswahl im Demo-Menue
    - main/BLE_OBD/ble_obd.c/.h: BLE-GATT-Client fuer ELM327-kompatible Adapter,
    generische RX/TX-Charakteristik-Erkennung, Pairing-Fallback 1234/5678/0000,
    AT-Init + Standard-OBD2-PID-Polling, DTC-Lesen/Loeschen/Service-Reset
    - main.c: BLE_OBD_Init() nach CAN_OBD2_Init()
    - bmw_ui.c: Demo-Menue-Buttons verkleinert/nach unten verschoben (kein
    Overlap mehr mit Tab-Leiste), neue BLE-OBD/MCP-Auswahlbuttons (Standard:
    BLE OBD), alle Live-Werte/DTC/Logging schalten je nach Auswahl um
    [bmw_ui.c, main.c]
2026-09-25 S3: README um BLE-OBD-Optionen ergaenzt, Release-Workflows setzen Tag und Commit-Text
2026-09-25 S3: SD-Log mit fsync nach jedem Flush, damit Daten wirklich auf der Karte landen
2026-09-26 S3: Service-Screen (Oel/Bremsen/Entlueften/NOx), Versionsnummer 1.0.0 im Screen, versionierte Firmware und Release je Version
2026-09-26 S3: BLE-Datenkanal ohne ISSC-Config-Chars waehlen, reset_reason im SD-Log, SD-Task-Stack 8192, v1.0.3
    [sd_log.c]
2026-09-30 S3: DTC-Auslesen/Loeschen/Service-Reset loggen jetzt immer (auch online), Statuslabel im Fehlercode-Screen, v1.0.4
    [bmw_ui.c]
2026-10-01 S3: BTC/BTU-Bluetooth-Task-Stacks vergroessert, RX-Notify-Logging nur solange offline, v1.0.5
    Verdacht auf Stack-Ueberlauf im Bluedroid-BTC-Task als Mitursache fuer
    sporadische reset_reason=4/7-Boot-Loops: RX-Notify wurde bisher auch im
    Online-Zustand bei jedem Poll geloggt (char fb[200] + OBD_LOGI/SD_Log im
    BTC-Callback-Kontext mit begrenztem Stack), jetzt analog zum TX-Pfad nur
    solange die Verbindung noch nicht online ist. Zusaetzlich BTC/BTU-Stacks
    auf Verdacht erhoeht (3072->4096 / 4096->6144) und ble_obd_task-Stack von
    4096 auf 6144. Nicht kompiliert, nicht am Board verifiziert.
2026-10-01 S3: WRITE_CHAR-Logging im Online-Betrieb gedrosselt, Coredump-Partition + Auto-Auslesen ins SD-Log, Button-Taps immer geloggt, v1.0.7
    [partitions.csv]
2026-10-01 S3: Bordnetzspannung live per OBD2 statt Board-ADC, dunklere blaue Buttons, BT-Init um 700ms verzoegert, RGB-ISR IRAM-safe gegen Bildverzerrung, SD-Log-Zeilenlaenge erhoeht, v1.0.9
2026-10-02 S3: IRAM-safe-ISR-Flags fuer RGB-Panel wieder entfernt (Display blieb schwarz bei PSRAM-Framebuffer ohne Bounce-Buffer), v1.0.10
2026-10-02 S3: RGB-Panel auf Single-Framebuffer+Bounce-Buffer+Vsync-Sem umgestellt (Tearing-Fix fuer verzerrte Multi-Kachel), v1.0.11
2026-10-02 S3: Build-Fix fuer Vsync-Sem-Extern-Deklarationen, blaue Buttons weiter abgedunkelt, v1.0.12
    [ST7701S.c, bmw_ui.c]
2026-10-04 S3: RGB-Panel zurueck auf Doppel-Framebuffer (schwarzes Display bei Single-FB+Bounce-Buffer), Tearing bleibt offen, v1.0.13
2026-10-04 S3: DTC-Screen Layout ueberarbeitet (Titel/Liste/Status/Buttons), Service-Buttons Beschriftung+Schrift, v1.0.16
2026-10-04 S3: OBD2-Bordnetzspannung (ATRV) um +0.31V korrigiert (Carly-Vergleich), v1.0.17
2026-10-05 S3: Build-Fehler behoben (LV_COLOR_MAKE als Funktionsargument ungueltig), v1.0.20
    LV_COLOR_MAKE(...) expandiert zu einem Brace-Initializer ({{...}}) und ist nur
    als Initializer gueltig (lv_color_t x = LV_COLOR_MAKE(...)), nicht als
    Ausdruck in einem Funktionsaufruf. In lv_meter_add_arc() fuer den
    Farbring-Indikator (multi_ring_yellow) wurde es faelschlich direkt als
    Argument uebergeben -> Compile-Fehler "expected expression before '{' token"
    in lv_color.h, der sich als "too few arguments" in bmw_ui.c zeigte. Fix:
    lv_color_make(224, 255, 0) (die Funktion, die einen echten lv_color_t
    zurueckgibt) statt des Makros.
    [bmw_ui.c]
2026-10-05 S3: Demo-Buttons mittig statt abgeschnitten, groesserer Center-Touch-Bereich, neuer Funktionen-Screen (Wisch rechts ab Farben) mit Datenlogging/Anzeige-Umschalter + Warnsummer ab 120 Grad, v1.0.21
2026-10-05 S3: WLAN-Firmware-Update (OTA) im Onboard-Panel, Zwei-Slot-Partitionstabelle, v1.0.22
    Schalter "WLAN-Update" im originalen Waveshare-Einstellungspanel baut einen
    eigenen WLAN-AP auf, zeigt SSID/IP auf dem Display und bietet eine einfache
    Webseite zum Hochladen einer .bin-Firmwaredatei (main/OTA_Web/ota_web.c).
    Partitionstabelle auf ota_0/ota_1/otadata umgestellt, CI-Merge-Offset
    entsprechend angepasst. Einmaliges reguläres USB-Flashen von v1.0.22 nötig,
    danach WLAN-Updates für Folgeversionen möglich.
    [partitions.csv]
2026-10-05 S3: Boot-Logo, Update-Image-Erkennung + _update-Namensschema, nur noch S3-CI, v1.0.23
    Boot-Logo: 1,8s Vollbild-Logo (boot_logo_img.c/.h, 480x480 RGB565) direkt
    nach LVGL-Init, bevor Demo-Screen/BMW-UI aufgebaut werden.
    OTA-Web: Firmware-Update-Datei heisst jetzt firmware-s3-update.bin (statt
    firmware-s3.bin), damit sie sich nicht mit der -merged.bin verwechseln
    laesst. Zusaetzlich liest ota_web.c nach den ersten Bytes den App-
    Beschreibungsblock (esp_app_desc_t) aus der beschriebenen Partition zurueck
    und bricht den Upload ab, falls das ESP_APP_DESC_MAGIC_WORD fehlt - erkennt
    damit zuverlaessig, wenn versehentlich die -merged.bin statt der
    *_update.bin hochgeladen wurde.
    build.yml (C6/Plat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
2026-10-05 S3: Farbring-Position korrigiert (eigene Skala statt Nadel-Hilfsskala), Ring weiter nach aussen, v1.0.24
    [bmw_ui.c]
2026-10-05 S3: Farbring weiter nach aussen, Funktionen-Buttons zur Mitte, WLAN-Update-Absturz behoben (AP-Start im Hintergrund-Task), v1.0.25
    [bmw_ui.c]
2026-10-05 S3: Farbring weiter nach innen versetzt, QR-Code fuer WLAN-Update, Beenden-Bug behoben, Start-Diagnose-Logging, v1.0.26
    [bmw_ui.c]
2026-10-05 README: Foto der Multi-Ansicht ergaenzt, UI-Abschnitt auf aktuellen Stand gebracht
    Beschreibt jetzt Farbring (Wasser/Drehzahl, Gelb/Orange/Rot), Blink-Schwelle
    112 Grad, Service-Screen, Funktionen-Screen (Datenlogging/Wasser-Drehzahl-
    Umschalter/Buzzer ab 120 Grad) und QR-Code im WLAN-Update.
2026-10-06 S3: BLE-Scan-Dubletten-Filter aktiviert (Bootloop-Verdacht bei vielen BLE-Geraeten im Auto), BLE_OBD_Suspend/Resume waehrend WLAN-Update, v1.0.28
2026-10-06 S3: SD-Auto-Format bei fehlgeschlagenem Mount deaktiviert (Dauerbootloop-Ursache), v1.0.29
    format_if_mount_failed=true konnte eine mehrere-GB-Karte blockierend
    minutenlang formatieren; ein Reset mitten in diesem Vorgang liess die
    Karte halb formatiert zurueck, wodurch jeder Boot sofort wieder einen
    (abbrechbaren) Formatierungsversuch startete, noch vor SD_Log_Init()
    und dem Boot-Logo. Fehlgeschlagener Mount wird jetzt uebersprungen statt
    neu formatiert.
    [SD_MMC.c]
2026-10-06 S3: Einstellungen persistent in NVS, SNTP-Zeitabgleich ueber SD-Karten-Config, v1.0.34
    Farben, Datenquelle (BLE/MCP), Datenlogging, Wasser/Drehzahl-Umschalter und
    Warnsummer werden jetzt in NVS gespeichert und beim Boot wiederhergestellt.
    WLAN-Zugangsdaten fuer den einmaligen SNTP-Abgleich stehen nicht mehr im
    Code (oeffentliches Repo), sondern werden aus /sdcard/wifi-einstellungen.txt
    gelesen; fehlt die Datei, wird eine Vorlage mit Beispiel angelegt.
2026-10-06 S3: Einstellungen persistent in NVS, SNTP-Zeitabgleich ueber SD-Karten-Config, v1.0.37
    - fopen()-Bootloop beim Wiederherstellen von "Datenlogging an" behoben (verzoegerter Start statt synchron im UI-Aufbau)
    - SNTP-Zeitabgleich jetzt manuell per Hotspot-Schalter im Funktionen-Screen ausgeloest statt automatisch beim Boot, Status wird nicht dauerhaft gespeichert
    - Neuer Sensoren-Screen (Lambda B1/B2, Lambda-Spannung, Ansaugdruck) per Wisch rechts vom Service-Screen, Ladedruck/Nockenwellenposition als n/v da keine Standard-OBD2-PID existiert
    - READMEs aktualisiert
    [bmw_ui.c, can_obd2.c, can_obd2.h, main.c]
2026-10-06 S3: SD-Karten-Mount wird bei Bedarf nachtraeglich wiederholt (SD_EnsureMounted), behebt SD-Fehler bei Datenlogging und fehlende wifi-einstellungen.txt, v1.0.38
2026-10-06 S3: SNTP-Hotspot-Ablauf praezisiert (SD-Mount-Pruefung, getrennte Statustexte, Logging, groesserer Stack), v1.0.39
2026-10-06 S3: Bootloop-Schutz fuer Datenlogging-Wiederherstellung, Heap-Diagnose vor fopen(), SNTP-Task-Erstellung abgesichert, v1.0.40
    Coredump aus dem Nutzerlog aufgeloest: fopen() in start_datalogging()
    stuerzt ab (newlib Lock-Allokation), wenn Datenlogging aus NVS wieder
    aktiviert wird - bmw_settings_save() speicherte den Zustand bisher
    unabhaengig vom Erfolg, was zu einem Dauer-Bootloop mit eingelegter
    SD-Karte fuehrte. Ein NVS-Fehlversuchszaehler schaltet Logging nach
    2 gescheiterten Boots automatisch dauerhaft ab. SNTP_Sync_Start()
    prueft jetzt den Rueckgabewert von xTaskCreatePinnedToCore(), damit
    ein fehlgeschlagener Task-Start nicht den Hotspot-Status dauerhaft
    bei "Starte..." haengen laesst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
2026-10-06 S3: Button zum Formatieren der SD-Karte im Funktionen-Screen, v1.0.41
    Loest "SD-Fehler!"/"Fehler: zu wenig Speicher", wenn die Karte nie
    erfolgreich mountet, weil sie unformatiert oder beschaedigt ist.
    SD_Format() formatiert eine bereits gemountete Karte neu
    (esp_vfs_fat_sdcard_format) oder erzwingt bei nicht gemounteter Karte
    einmalig einen Formatierungs-Mount. Laeuft in einem eigenen Task, aktives
    Datenlogging wird vorher gestoppt.
2026-10-07 S3: SNTP-Task einmalig beim Boot statt pro Klick, CSV-Datenlogging fsync, SD-Format/SNTP/Logging gegeneinander synchronisiert, WiFi-Treiber nur bei Bedarf (de)initialisiert, v1.0.45
2026-10-07 S3: Sensoren-Screen startet/stoppt Lambda/MAP-Abfrage beim Rein-/Rausswipen statt Dauerpolling, v1.0.46
2026-10-07 S3: WiFi-Init/Deinit-Fehler ins SD-Log statt nur UART, Treiber-Flag nur bei erfolgreichem Deinit zuruecksetzen, v1.0.48
2026-10-16 S3: LED-Control-Screen fuer WS2812B/SK6812 (Solid/Chase, GPIO0, bis 100 LEDs), Verdrahtungsbild per lottie erstellt, README aktualisiert, v1.0.51
2026-10-16 S3: fehlende Deklaration von led_enable_switch ergaenzt (Build-Fehler aus v1.0.51), v1.0.52
2026-10-17 S3: Zweiter unabhaengiger LED-Streifen (GPIO19, Konflikt mit MCP2515 optional), Verdrahtungsplan inkl. KFZ-Stromversorgung/Batterie neu gezeichnet, v1.0.54
2026-10-17 S3: SD-Schreiben robuster gegen abrupten Stromverlust, LED-Helligkeitsregler+Farbpopup, BMW-Style-Multiview-Design, v1.0.58
2026-10-17 S3: Download-Link fuer SD-Logfile auf der OTA-Update-Seite, v1.0.59
2026-10-18 S3: RTC lostPower-Erkennung, BMW-Hintergrundfoto fuer Multiview, WLAN-Zugangsdaten per OTA-Seite editierbar, v1.0.63
    - PCF85063_Lost_Power() liest OS-Flag aus, Status wird beim Boot ins SD-Log geschrieben
    - BMW-Style-Multiview nutzt jetzt echtes Hintergrundfoto (multi_bg_bmw_img) statt synthetischer Skala,
    Wasser-Ring + kleine Nadel wachsen gegen den Uhrzeigersinn im unteren Bogen, Bild leicht gezoomt/verschoben
    - OTA-Update-Seite: Download-Link fuers SD-Logfile sowie SSID/Passwort-Felder zum Anzeigen und Speichern
    der Hotspot-WLAN-Zugangsdaten (wifi-einstellungen.txt) ohne SD-Karte auszubauen
2026-10-18 S3: Build-Fehler fixen (implicit fsync), v1.0.64
    ota_web.c nutzte fsync() ohne <unistd.h> - mit -Werror=implicit-function-declaration
    bricht der ESP-IDF-Build deshalb ab (Fehler in CI-Run 39141380649, Commit b1edac1).
2026-10-18 S3: OTA-Partitionen von 3M auf 4M vergroessert, v1.0.65
    Firmware ueberschreitet seit den letzten Features (BMW-Hintergrundbild etc.)
    die alten 3M-Slots (0x35d390 Bytes, Overflow 0x5d390) - Build schlug mit
    "All app partitions are too small" fehl. ota_0 bleibt bei Offset 0x20000
    (CI-Merge-Offset unveraendert), ota_1/flash_test/coredump ruecken entsprechend
    nach hinten; 16MB-Flash hat dafuer reichlich Platz (~9MB bleiben frei).
2026-10-21 Add MIL, oil temp, boost pressure and auto protocol detection (BLE)
    Based on TomWis97/bmw-obd2-display: MIL via Mode 01 PID 0x01, oil
    temperature via BMW UDS service 0x22 PID 0x4402, boost pressure from
    intake manifold pressure minus barometric pressure (PID 0x33), and
    ATSP0 auto protocol detection for the BLE ELM327 path.
2026-10-23 BMW-Style kleine Wassernadel aus Original-BMW-Tachofotos, Farbring-Position korrigiert, v1.0.67
    Die zweite, kleine Wassertemperatur-Nadel im BMW-Style nutzte bisher die
    grossen needle_*_img-Assets (87x276px, fuer die C6-Rundinstrumente gedacht)
    in einem nur 110px grossen Meter-Widget - das vergroesserte den von LVGL
    reservierten Redraw-Bereich weit ueber das Widget hinaus und bremste den
    gesamten BMW-Style-Screen spuerbar aus (u.a. verschluckte Doppeltipps).
    Neue, passend zugeschnittene needle_small_*_img-Assets aus den vom Nutzer
    bereitgestellten Fotos des echten BMW-Tachozeigers (dunkler Rundknopf +
    farbiger Schaft) ersetzen sie.
    MULTI_WATER_ARC_ROTATION stand auf 125 (Bogenmitte bei 9 Uh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
2026-10-24 BMW-Style: Performance-Fix (kein BG-Zoom), zweiter Style-Switch im Langdruck-Screen, Nadel/Farbring nachjustiert, v1.0.69
    - Performance: lv_img_set_zoom(262) vom BMW-Foto-Hintergrund entfernt. Das
    Bild ist bereits 466x466 (Vollbild), der Zoom war rein kosmetisch (~5px),
    zwang LVGL aber bei jedem Teil-Redraw ueber dem Hintergrund in den teuren
    Transformations-Renderpfad. Da die Nadel-Updates (100ms) staendig Bereiche
    darueber neu zeichnen, war der ganze BMW-Style-Screen traege (Wischen kaum
    moeglich, Nadel/Drehzahl stark verzoegert). Ohne Zoom fuellt das Foto den
    Schirm 1:1 und alle Redraws nehmen den schnellen Pfad.
    - Zweiter BMW-Style-Umschalter direkt auf dem Langdruck-/Demo-Sc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
2026-10-25 SD-Karten-Update: update.bin im Root wird beim Boot eingespielt, v1.0.71
    Analog zum WLAN-Update in ota_web.c (gleiche App-Header-Validierung),
    aber ohne Hotspot - einfach update.bin auf die SD-Karte legen. Wird
    nach dem Einspielen (Erfolg oder Fehlschlag) in update.backup
    umbenannt, damit keine erneute Einspielung bei jedem weiteren
    Neustart passiert.
2026-10-27 Datenlogging per SD-Konfigurationsdatei einstellbar machen, Konfig-Datei bereits beim Boot anlegen, v1.0.74
    - DATALOGGING=1/0 in wifi-einstellungen.txt, analog zu LAYOUT=: ueberschreibt
    beim Boot den NVS-Zustand (load_startup_datalogging_from_sd()) und wird beim
    Umschalten des Datenlogging-Schalters zurueckgeschrieben
    (save_startup_datalogging_to_sd()).
    - Neue SNTP_Sync_EnsureConfigFile(), in main.c direkt nach SD_Log_Init()
    aufgerufen: legt die Konfigurationsdatei (SSID/PASSWORT/LAYOUT/DATALOGGING)
    schon beim allerersten Boot an, statt erst beim ersten "Hotspot verbinden"-
    Versuch - bisher fehlte sie auf Karten, die dafuer nie genutzt wurden.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
2026-10-27 CI: otadata-Region in merged S3-Firmware-Image auf 0xFF zuruecksetzen, v1.0.76
    Nach einem OTA-Update (SD-Karte/WLAN) zeigt otadata (0xf000) dauerhaft auf
    den zuletzt gebooteten Slot (ota_0/ota_1). Ein PC-Flash der merged-bin hat
    otadata bisher nie beruehrt, dadurch blieb der Bootloader auf dem alten
    Slot stehen und eine frisch per esptool geflashte Firmware (immer ota_0)
    wurde nie gestartet - Ursache fuer den schwarzen Bildschirm trotz
    erfolgreichem PC-Flash. Jetzt wird otadata als blanke 0xFF-Region mit in
    die merged-bin aufgenommen, damit ein PC-Flash immer deterministisch
    wieder auf ota_0 zurueckfaellt.
2026-10-27 Boot-Logo vor neue SD-Update/Config-Schritte vorziehen (Diagnose schwarzer Bildschirm seit v1.0.69), SD_Init_Done-Fehlpruefung in SD_Update_CheckAndApply gefixt, v1.0.77
    Einziger main.c-Unterschied zwischen der zuletzt sicher funktionierenden
    v1.0.68 und der ersten schwarzen-Bildschirm-Version v1.0.73 ist der neu
    eingefuegte Aufruf von SD_Update_CheckAndApply() direkt nach SD_Log_Init(),
    spaeter ergaenzt um SNTP_Sync_EnsureConfigFile(). Da danach bei den
    betroffenen Boots kein neuer "=== Start ==="-Logeintrag mehr geschrieben
    wurde (SD_Log_Init() fsynct diese Zeile synchron), ist unklar, ob der
    Haenger wirklich in einer dieser beiden Funktionen liegt oder schon davor -
    LVGL_Init()/show_boot_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
2026-10-28 Schwarzer Bildschirm seit v1.0.71: zwei neue static-Puffer (sd_update.c, bmw_ui.c) auf malloc/free umgestellt, v1.0.78
    heap_init zeigte 170 KiB freies internes RAM bei v1.0.68 (lief), aber nur
    159 KiB bei v1.0.77 (schwarzer Bildschirm) - exakt die 10,5 KB, die die neu
    eingefuehrten "static uint8_t buf[4096]" (sd_update.c) und
    "static char s_layout_cfg_lines[40][160]" (bmw_ui.c) dauerhaft im
    .bss-Segment reservieren, obwohl sie nur kurz gebraucht werden. Zusammen mit
    dem Speicher, den WiFi/BLE schon vor LCD_Init() belegen, reichte das nicht
    mehr fuer die DMA-Puffer des RGB-LCD-Panels: esp_lcd_new_rgb_panel()
    schlaegt mit ESP_ERR_NO_MEM fehl, ST7701S.c:483 ruft ESP_ERROR_CHECK auf,
    das Geraet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
2026-10-28 BMW-Style Wassernadel vergroessert (37x66->52x92) und blauen HIGH-TEMP-Bogen nach aussen/schmaler gezogen, v1.0.79
    Nutzer-Feedback (Foto): die kleine Nadel ging im Gewirr der gedruckten
    gelben Skala unter, der blaue Bogen sass zu nah am Zentrum (ueberlappte
    die RPM-Schaltanzeige-Kaestchen statt unterhalb der Skala zu liegen) und
    war angular breiter als die gedruckte Skala.
    - needle_small_teal/yellow/red_img von 37x66 auf 52x92 hochskaliert
    (Faktor 1.4, premultiplied-alpha Lanczos-Resize aus den urspruenglichen
    Nutzerfotos rekonstruiert), Pivot proportional mitskaliert (20,17->28,24)
    - MULTI_WATER_ARC_RANGE 110->90 (schmalerer Bogen, passend zur gedruckten
    Skala), ROTATION/NEEDLE_ROTAT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
2026-10-28 RPM-Farbring blinkt ab Orange-Schwelle komplett rot, Takt wird naeher am Drehzahlbegrenzer (7000) schneller, v1.0.80
2026-11-03 Schaltanzeige blinkt rot synchron zum Farbring, Blinkbeginn 200 U/min frueher (6300), BMW-Style Batterie/Wasser nach innen und groesser (montserrat 36), v1.0.83
2026-11-03 BMW-Style: Batterie/Wasser wieder etwas nach aussen (-75/+78, im schwarzen Innenkreis), Geschwindigkeit groesser (montserrat 36) und tiefer (y=-112), v1.0.84
2026-11-04 BMW-Style: Wasser-Farbring und kleine Nadel exakt auf gedruckte HIGH-TEMP-Skala vermessen, Display-Drehung (+-1/+-45 Grad) im Funktionen-Screen, v1.0.85
2026-11-04 BMW-Diagnose: E90-Adressierung (0x6F1 + Steuergeraete-Adresse) fuer Oeltemperatur und CBS-Reset, BLE mit ATCEA/ATCAF0-Fallback, v1.0.86
2026-11-05 Teil-Redraw (LVGL direct_mode mit Framebuffer-Sync) statt full_refresh, UI-Setter nur bei echter Aenderung, v1.0.87
2026-11-09 Display-Drehung: Teil-Redraw auch bei aktiver Drehung (nur geaenderte Bereiche rendern und drehen), v1.0.88
